krocon/pi-case/fusion/model/pi5/doc/pi5/img.png

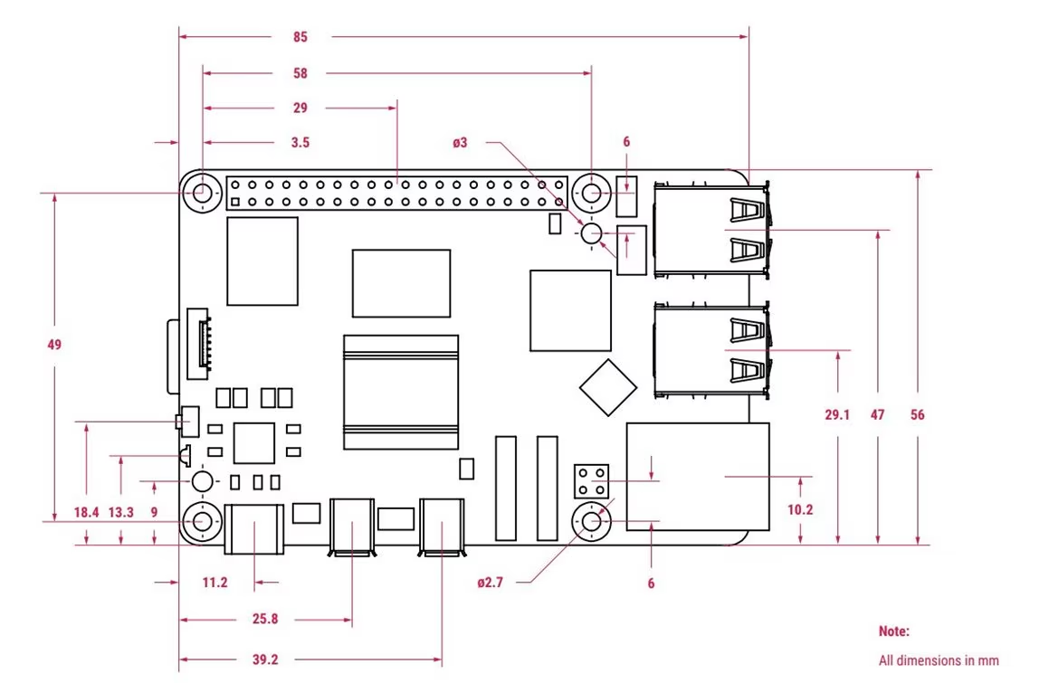
fusion/model/pi5/doc/pi5/img.png
