krocon/pi-case/fusion/model/pi5/doc/pi5/img_4.png

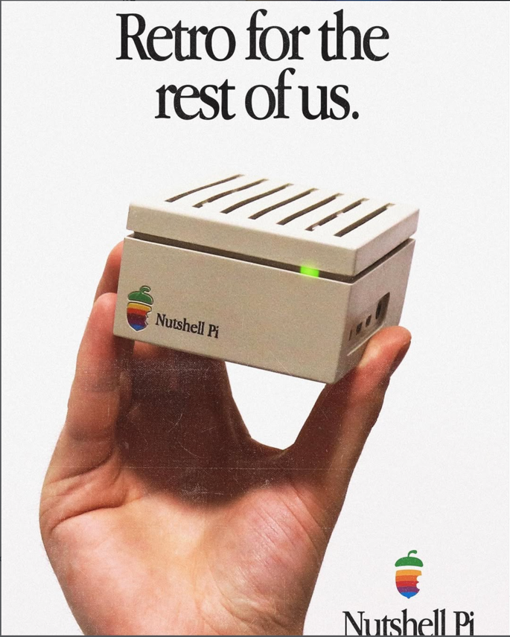
fusion/model/pi5/doc/pi5/img_4.png
