krocon/pi-case/fusion/model/pi5/doc/pi5/img_5.png

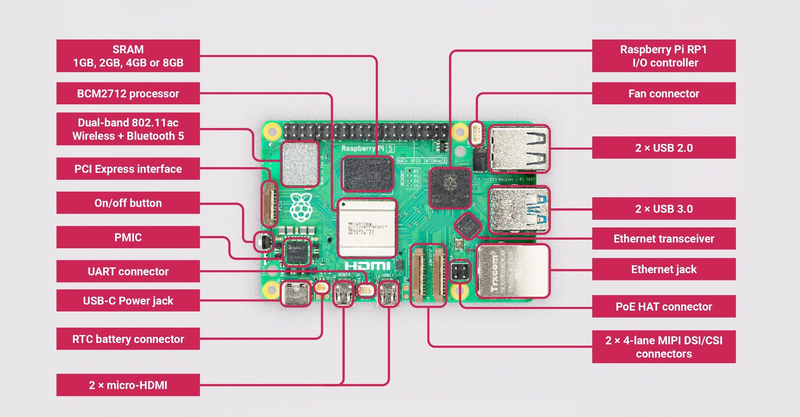
fusion/model/pi5/doc/pi5/img_5.png
