krocon/pi-case/fusion/model/pi5/prompt/p012/img.png

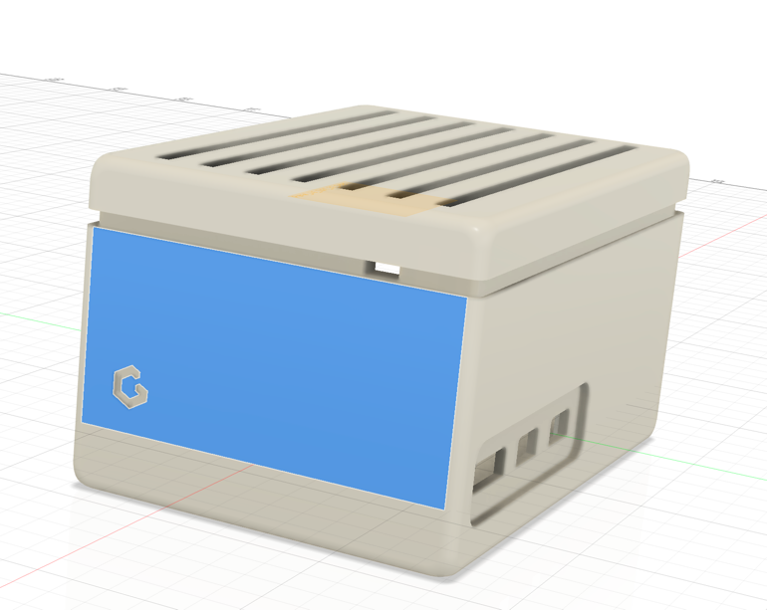
fusion/model/pi5/prompt/p012/img.png
