krocon/pi-case/fusion/model/pi5/prompt/p012/img_1.png

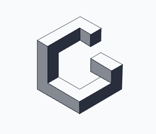
fusion/model/pi5/prompt/p012/img_1.png
