krocon/pi-case/fusion/model/pi5/prompt/p028/img.png

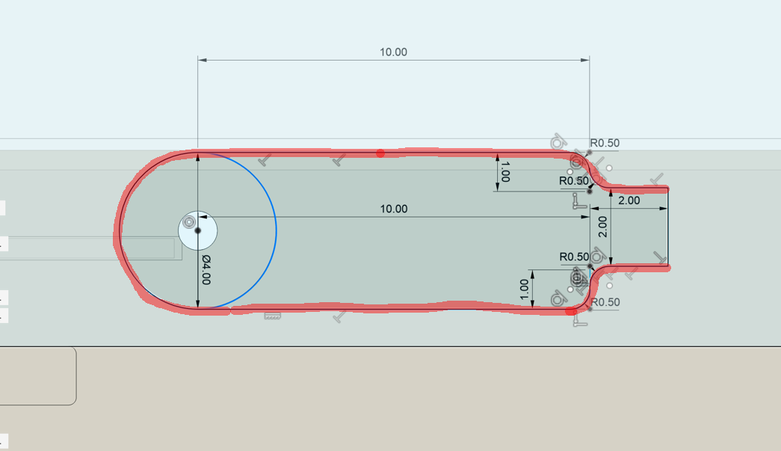
fusion/model/pi5/prompt/p028/img.png
