krocon/pi-case/fusion/model/pi5/pi5case/RASPBERRY_PI_5_1.stl

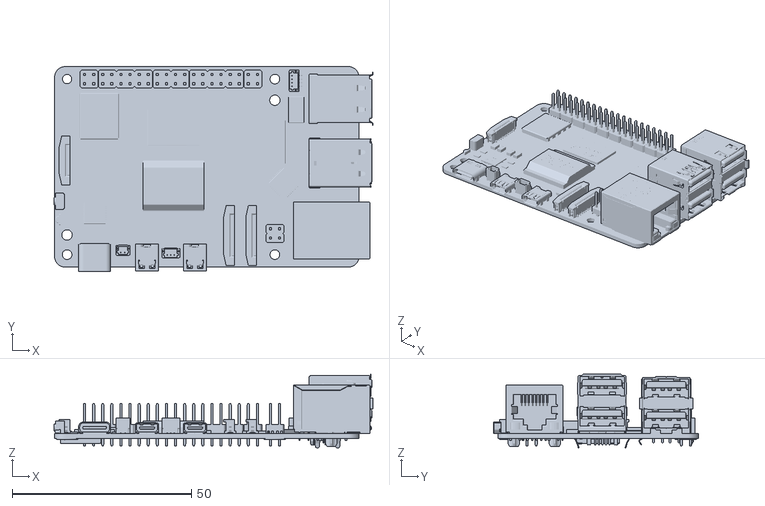
[picture p12: CAD file, 2026-09-26]
fusion/model/pi5/pi5case/RASPBERRY_PI_5_1.stl
89.0 x 57.2 x 20.6
