krocon/pi-case/fusion/model/pi5/print/PI5_case_merged_for_print_v2.1.step

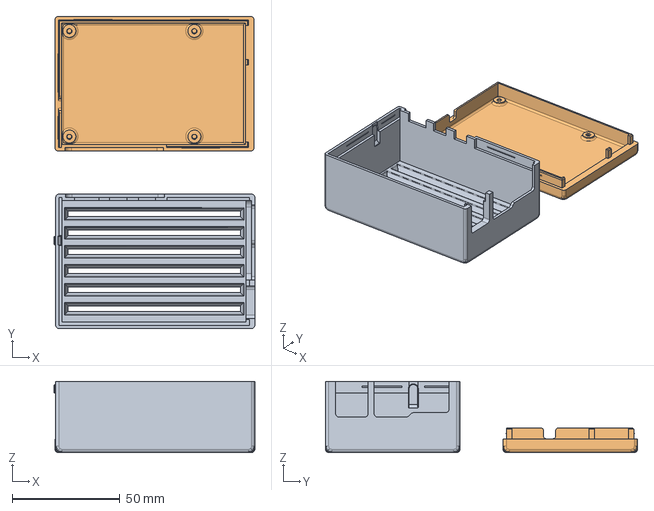
[picture p13: CAD file, 2026-09-26]
fusion/model/pi5/print/PI5_case_merged_for_print_v2.1.step
93.1 x 144.8 x 33.0 mm
