krocon/pi-case/fusion/model/pi5/print/PI5_case_merged_for_print_v2.3mf

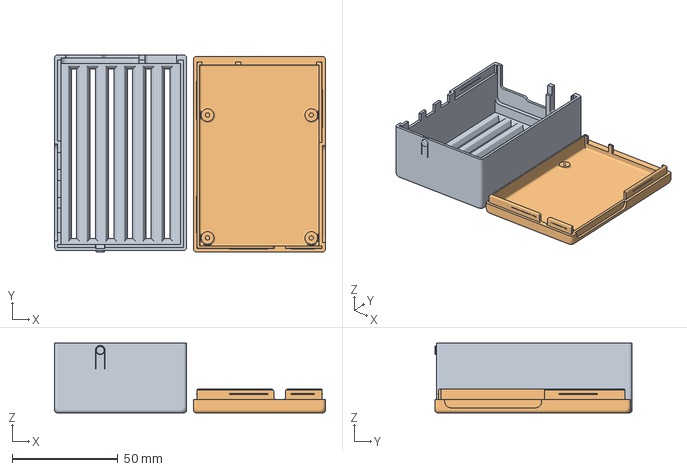
[picture p14: CAD file, 2026-09-26]
fusion/model/pi5/print/PI5_case_merged_for_print_v2.3mf
127.9 x 93.1 x 33.0 mm
(Unsaved)-SOLID-1
(Unsaved)-SOLID-2
