krocon/pi-case/fusion/model/pi5/print/PI5_case_for_print.step

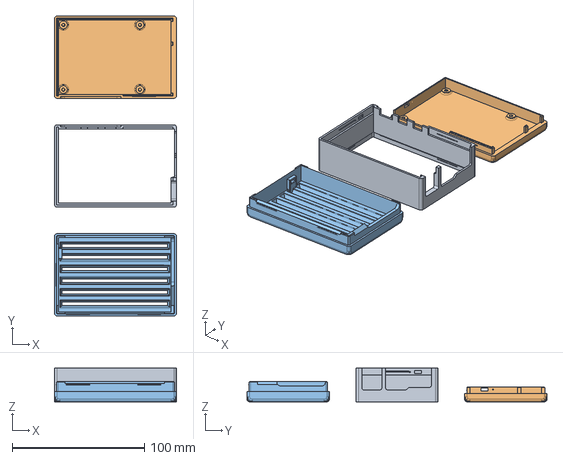
[picture p15: CAD file, 2026-09-26]
fusion/model/pi5/print/PI5_case_for_print.step
92.4 x 227.2 x 25.5 mm
