krocon/pi-case/fusion/model/pi5/print/PI5_case.step

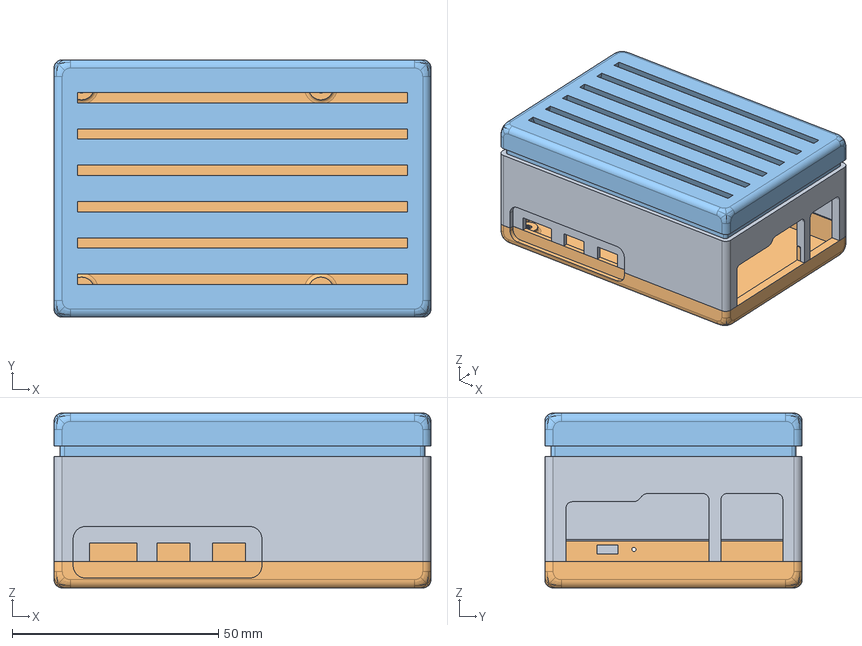
[picture p16: CAD file, 2026-09-26]
fusion/model/pi5/print/PI5_case.step
91.4 x 62.4 x 42.4 mm
