krocon/pi-case/fusion/model/pi5/print/PI5_case_merged_v2.1.step

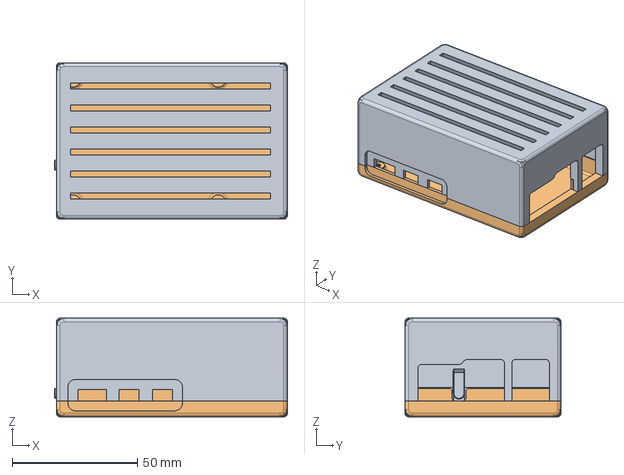
[picture p17: CAD file, 2026-09-26]
fusion/model/pi5/print/PI5_case_merged_v2.1.step
93.1 x 62.4 x 39.4 mm
