krocon/pi-case/fusion/model/pi5/print/PI5_case_merged_for_print.step

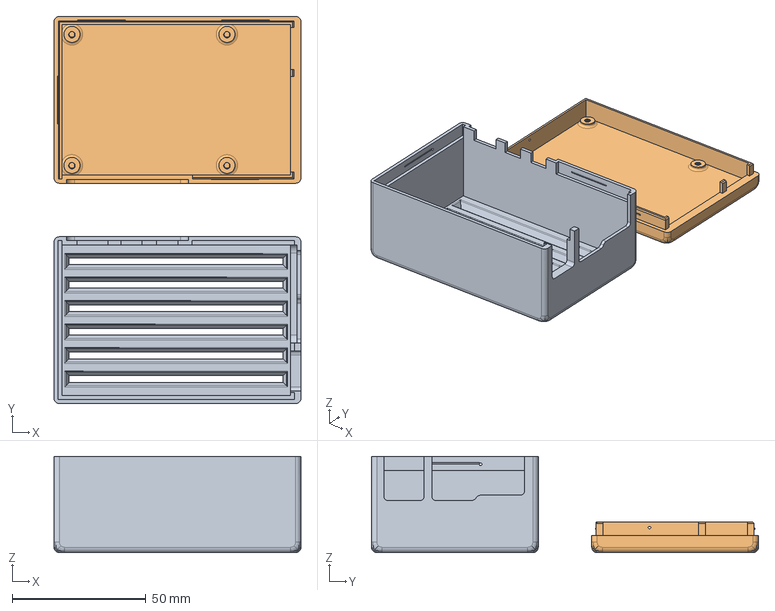
[picture p18: CAD file, 2026-09-26, an earlier design]
fusion/model/pi5/print/PI5_case_merged_for_print.step
92.4 x 144.8 x 36.0 mm
