krocon/pi-case/(list of files, cad)

Other CAD files:
fusion/model/pi5/print/PI5_case_for_print_plate_1.gcode.3mf
fusion/model/pi5/doc/pi5/RASPBERRY_PI_5_1.stl
fusion/model/pi5/doc/pi5/RASPBERRY_PI_5_1.f3d
fusion/model/pi5/pi5case/RASPBERRY_PI_5_1.f3d
fusion/model/pi5/print/PI5_case.f3d
fusion/model/pi5/print/PI5_case_for_print.3mf
fusion/model/pi5/print/PI5_case_for_print.f3d
fusion/model/pi5/print/PI5_case_merged_for_print.3mf
fusion/model/pi5/print/PI5_case_merged_for_print.f3d
fusion/model/pi5/print/PI5_case_merged_for_print_v2.1.f3d
fusion/model/pi5/print/PI5_case_merged_v2.1.f3d
