krocon/pi-case/fusion/model/pi5/makerworld/Pi 5 case/V02/img_4.png

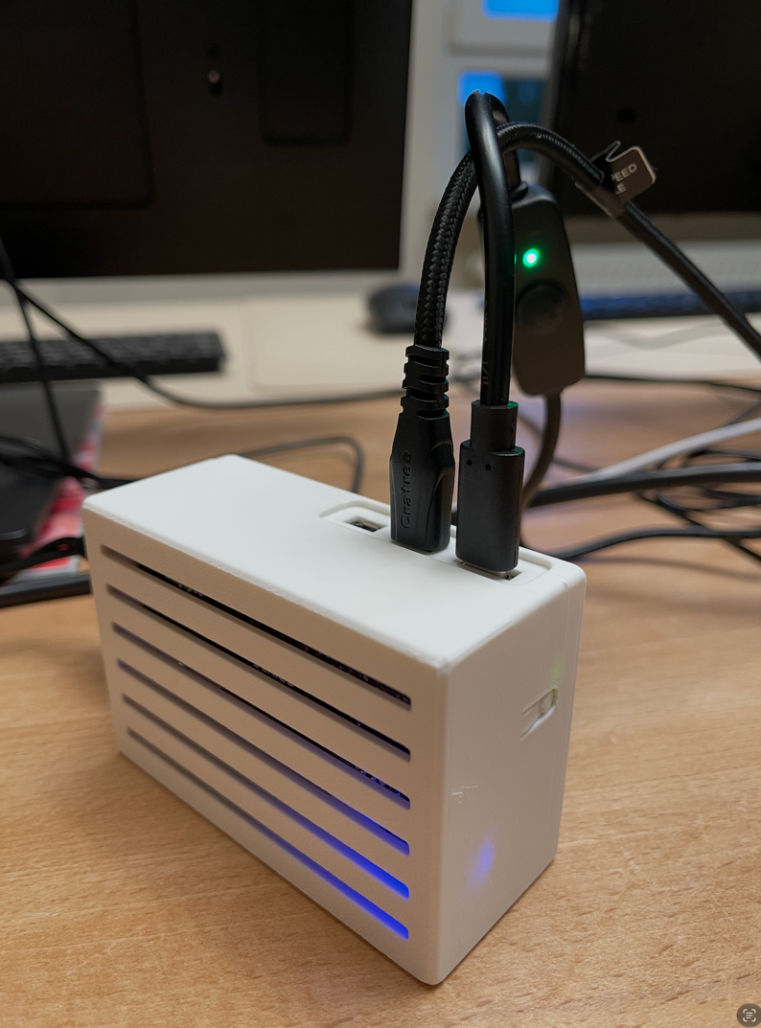
fusion/model/pi5/makerworld/Pi 5 case/V02/img_4.png
