krocon/pi-case/(commit log)

2026-09-26 Remove redundant SVG files and outdated prompt documentation.
    [RASPBERRY_PI_5_1.f3d, RASPBERRY_PI_5_1.stl]
2026-09-26 Refactor: simplify push-button tab design with straight layout and reduce Z-offset for improved compatibility.
2026-09-26 Update: adjust file timestamp in `PI5_case_merged_for_print_v2.1.step` to reflect latest changes.
    [PI5_case_merged_for_print_v2.1.f3d, PI5_case_merged_for_print_v2.1.step, PI5_case_merged_for_print_v2.3mf]
